PankajaBalasooriya/EN2533-Pulztrones/docs/Photos/PSX_20241214_182513 (1).jpg

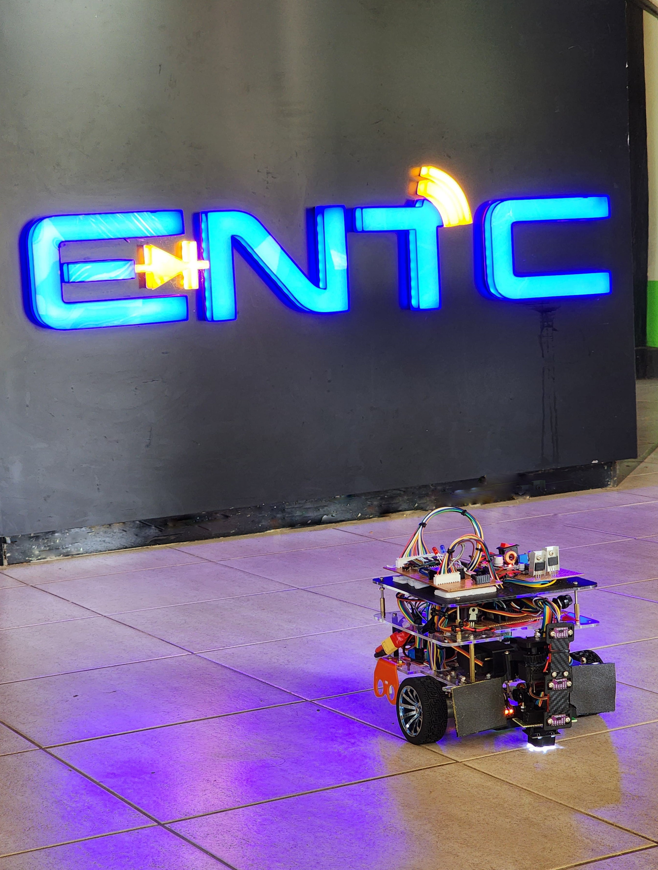
docs/Photos/PSX_20241214_182513 (1).jpg
