PankajaBalasooriya/EN2533-Pulztrones/Parts_List.xlsx

Component Name | Qty | Available (Yes/No) | Unit cost | Total Cost | Team Member /s | Notes
Arduino Mega | 1 | Yes |  |  | Pankaja
Raspberry pi | 1 | Yes |  |  | Pankaja
