PankajaBalasooriya/EN2533-Pulztrones/hardware/electrical/BOM.xlsx

Resistors
Item | Description | Designators | Package | Qty | Unit Price | Purchasing Link | Notes
