PankajaBalasooriya/EN2533-Pulztrones/hardware/mechanical/Coin Dropper/parts/Funnel.SLDPRT

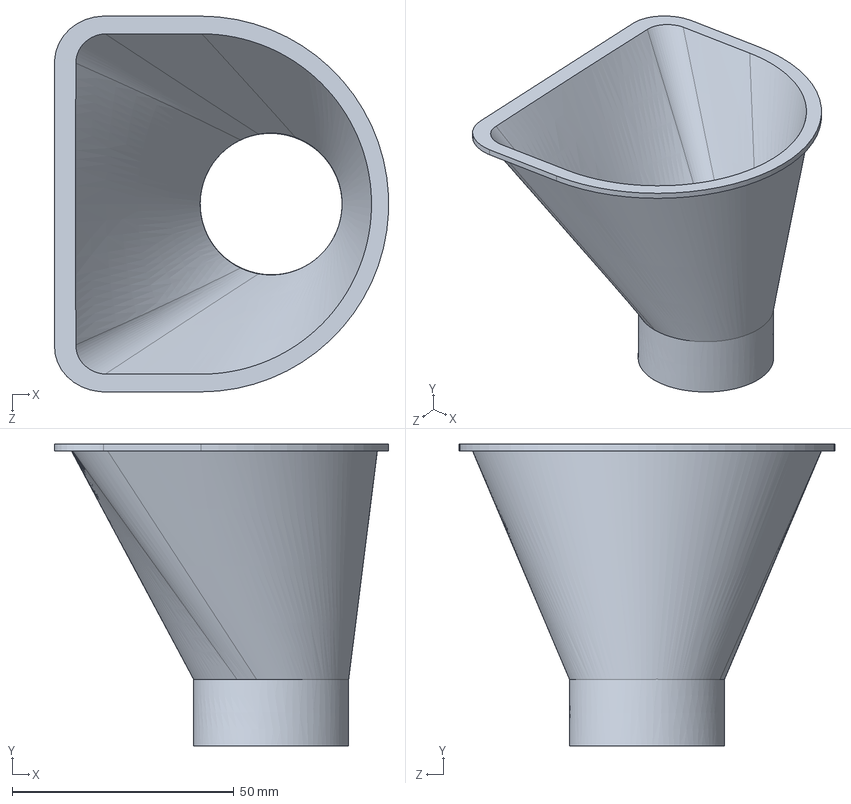
[picture p11: CAD file, 2024-09-17]
hardware/mechanical/Coin Dropper/parts/Funnel.SLDPRT
75.3 x 68.0 x 84.7 mm
