PankajaBalasooriya/EN2533-Pulztrones/hardware/mechanical/Coin Dropper/parts/2 rupee.SLDPRT

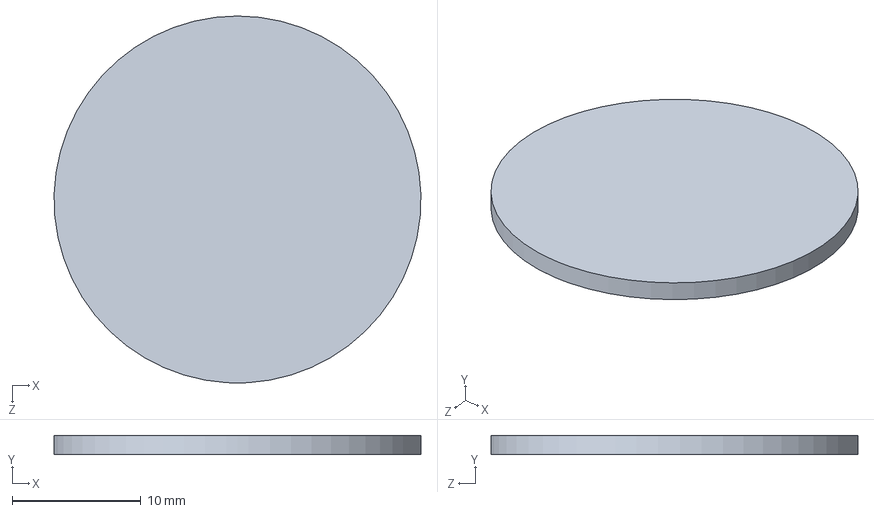
[picture p12: CAD file, 2024-09-17]
hardware/mechanical/Coin Dropper/parts/2 rupee.SLDPRT
28.5 x 1.50 x 28.5 mm
