PankajaBalasooriya/EN2533-Pulztrones/(list of files, drawings)

Other design files:
hardware/electrical/pulztrones/pulztrones.PrjPcb
hardware/electrical/pulztrones/Sheet1.SchDoc
