PankajaBalasooriya/EN2533-Pulztrones/(commit log)

2024-07-03 create folder structure
    [Budget.xlsx, Parts_List.xlsx, Timeline.xlsx]
2024-07-03 PCB Init
    [Pulztrones_PCB.PrjPcb]
2024-07-11 Implemeted PID Control Without ant Library
    [Parts_List.xlsx]
2024-07-11 PID Using Libraries + OLED Display
2024-08-10 Add files via upload
    Codes related to new motor encoder tests. To be updateted to read barcodes using IR sensors.
2024-08-12 files moved to arduino
2024-08-13 Stm32 motor control created
2024-09-17 added coin dropper design parts
    [2 rupee.SLDPRT, Funnel.SLDPRT]
2024-10-04 PCB design
    [Sheet1.SchDoc, pulztrones.PrjPcb]
2024-10-09 Updated encoder counting
2024-10-09 gyro data test
2024-10-15 PID for WhiteLine
    [error_data.csv]
2024-10-15 Encoder Counting
2024-10-25 sensor readings for debugging
2024-10-26 line following pid
    [error_data.csv]
2024-10-27 pid 1
2024-12-01 velocity profile added
2024-12-06 updated tof and gyro code
2024-12-06 made profiles and velocity controls
2024-12-08 added i2c mux
2024-12-08 added reverse line following, need to tune
    [main.cpp]
2024-12-09 checking tof sensors
2024-12-09 arm gripper done
2024-12-10 lift mechanisms and ultrasonic
2024-12-12 need to fix blue line thresholds
    [main.cpp]
2024-12-13 switched to portal
2024-12-14 dotted line not working
    [main.cpp]
